lwalter86/raspAccess/README.md

Code Health (https://landscape.io/github/lwalter86/raspAccess/master)
# raspAccess
Access control to a bicycle parking by nfc map with a raspberry pi and the explore-nfc extension card
