lwalter86/raspAccess/(list of files, drawings)

Other design files:
Carte1.SchDoc
Carte_fini.PcbDoc
