lwalter86/raspAccess/(commit log)

2015-06-29 Version finale étudiants
    [Carte1.SchDoc, Carte_fini.PcbDoc]
2015-12-22 declaration leds et bouttons
2015-12-23 nettoyage de code
